Rigo0825/ECEN_404/PartOrderLlist/PartOrderList.jpg

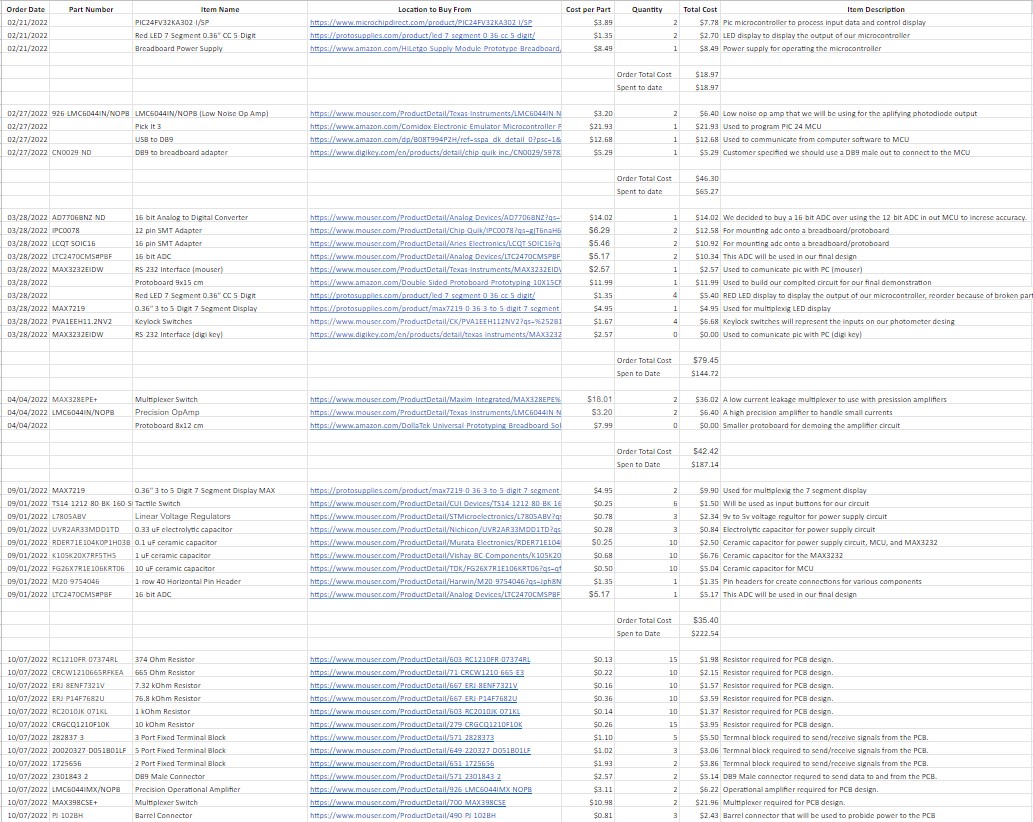
PartOrderLlist/PartOrderList.jpg
