Rigo0825/ECEN_404/README.md

# README

## Team 18 - Photometer ##

* Rigoberto Olivares
* Richard Lopez
* Hunter Cothran

## Introduction ##

This is a project for ECEN 404 - Electrical Design Lab. The project objective is to create a photometer that can be used to meassure the brightnes
of distant stars. This github repository will be used to document the code and design used in creating the photometer. Additionally, a "log" folder
will be used to give weekly written updates on the team's progress and struggles.

## Required Software ##

* MPLAB X IDE - 6.00

## Required Hardware ##

* PIC24FV32KA302
* PicKit 3 or equivalent pic microcontroller programmer
* Various other components

## External Deps  ##

* Git - Download the latest version at https://git-scm.com/book/en/v2/Getting-Started-Installing-Git
* MPLAB XC16 C-Compiler - Download the latest version at https://www.microchip.com/en-us/tools-resources/develop/mplab-xc-compilers

## Installation ##

Download this code repository by using git:

 git clone https://github.com/Rigo0825/Team18_Photometer.git

## Extra Help

Visit https://microchipdeveloper.com/projects:start for example project on programming pic mirocontrollers.
