Rigo0825/ECEN_404/Design/Microcontroller.pdf

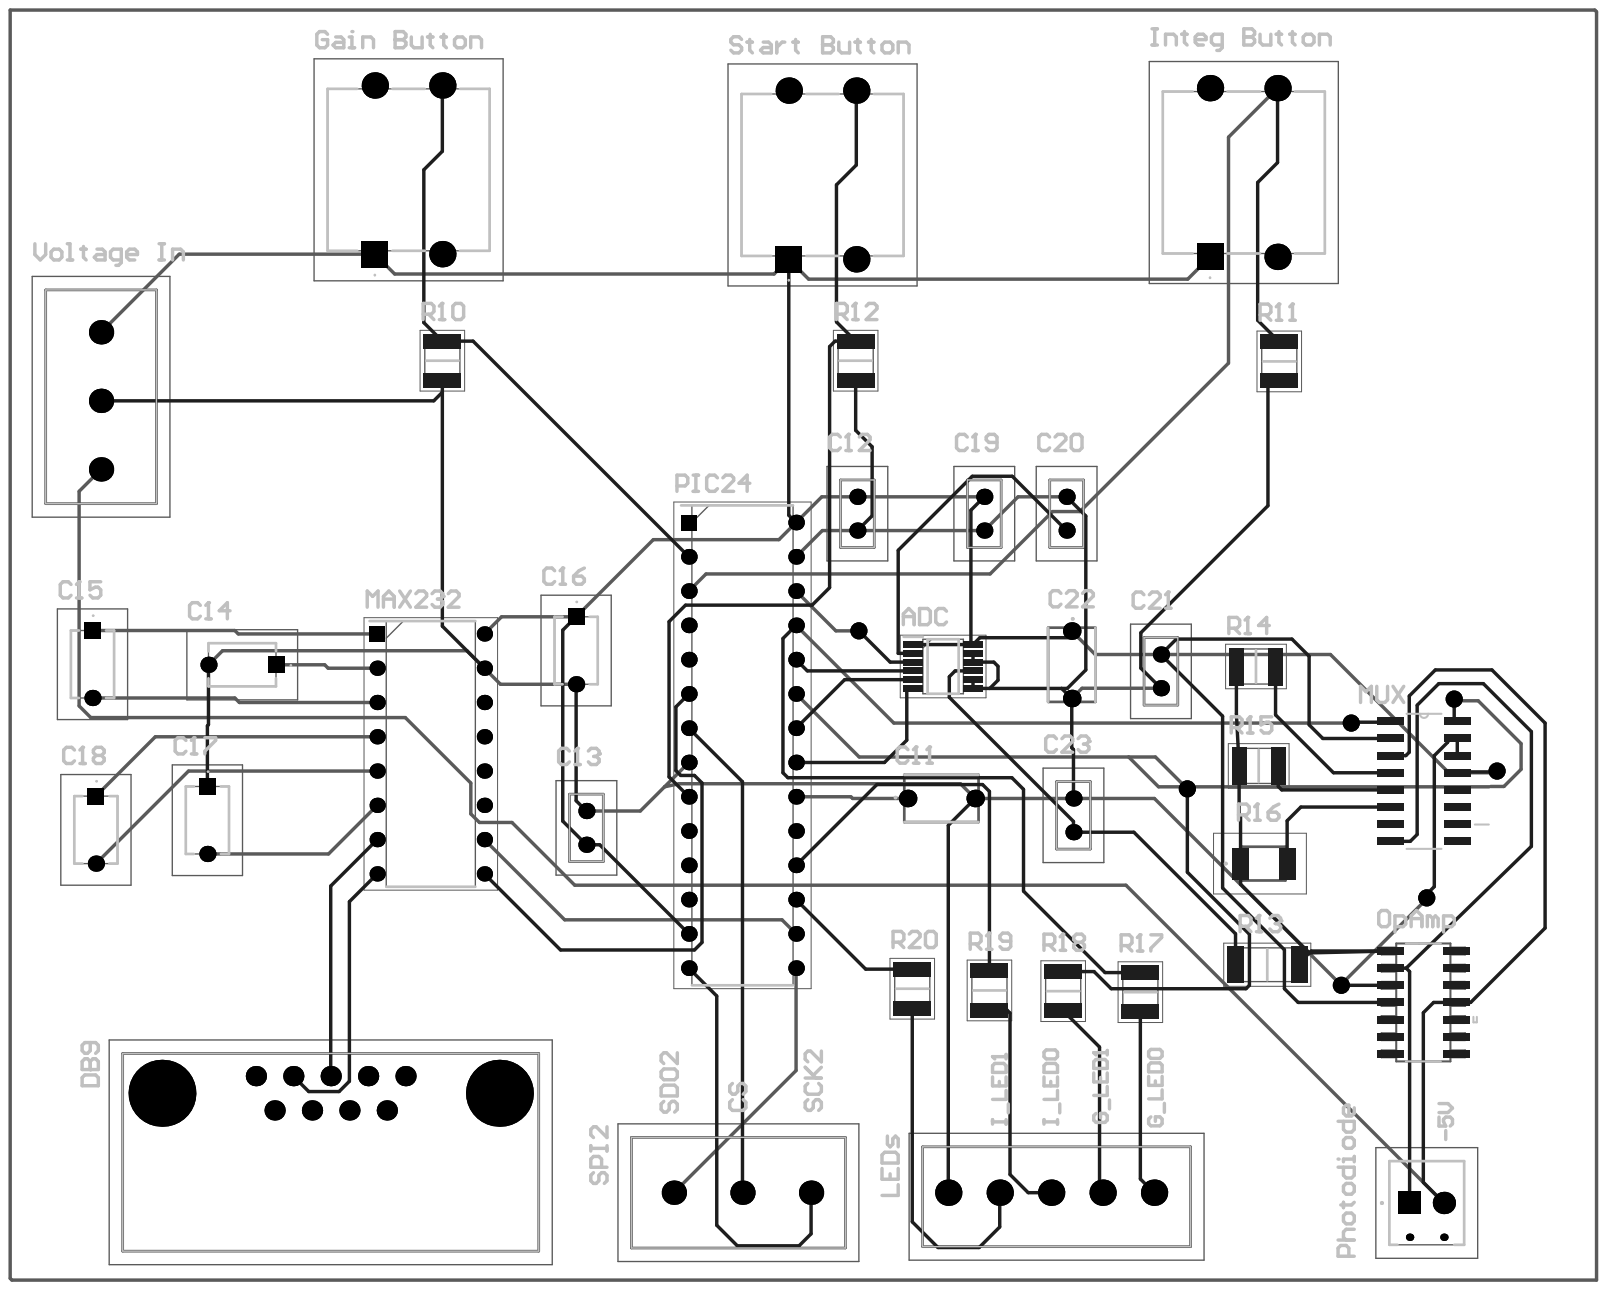
[picture p47: page 1]
