Rigo0825/ECEN_404/Design/Microcontroller_Schematic.pdf

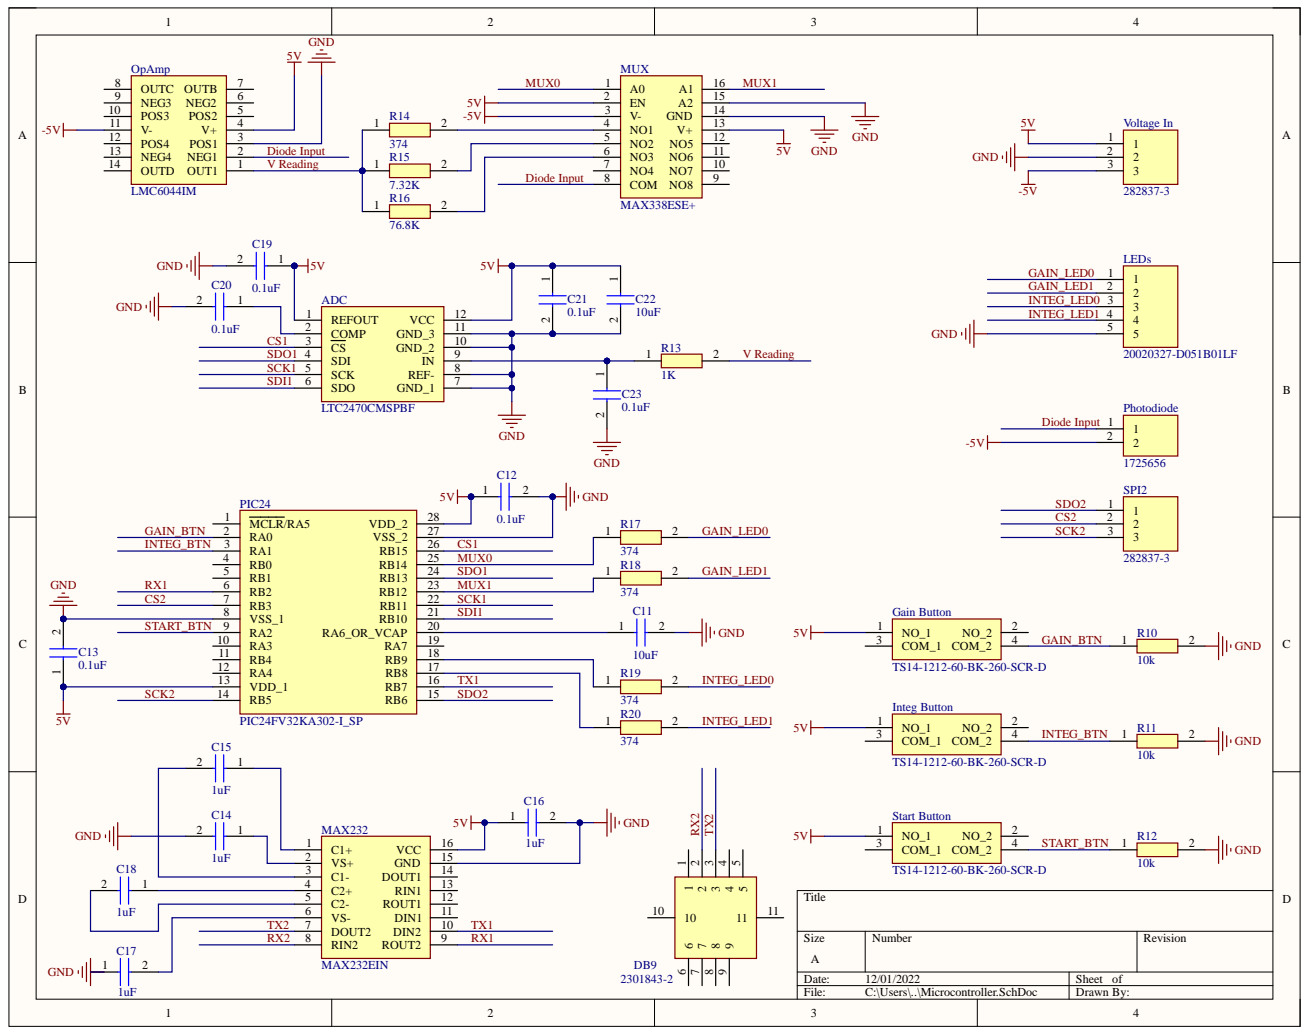
[picture p48: page 1]
