Rigo0825/ECEN_404/Design/Power_Supply.pdf

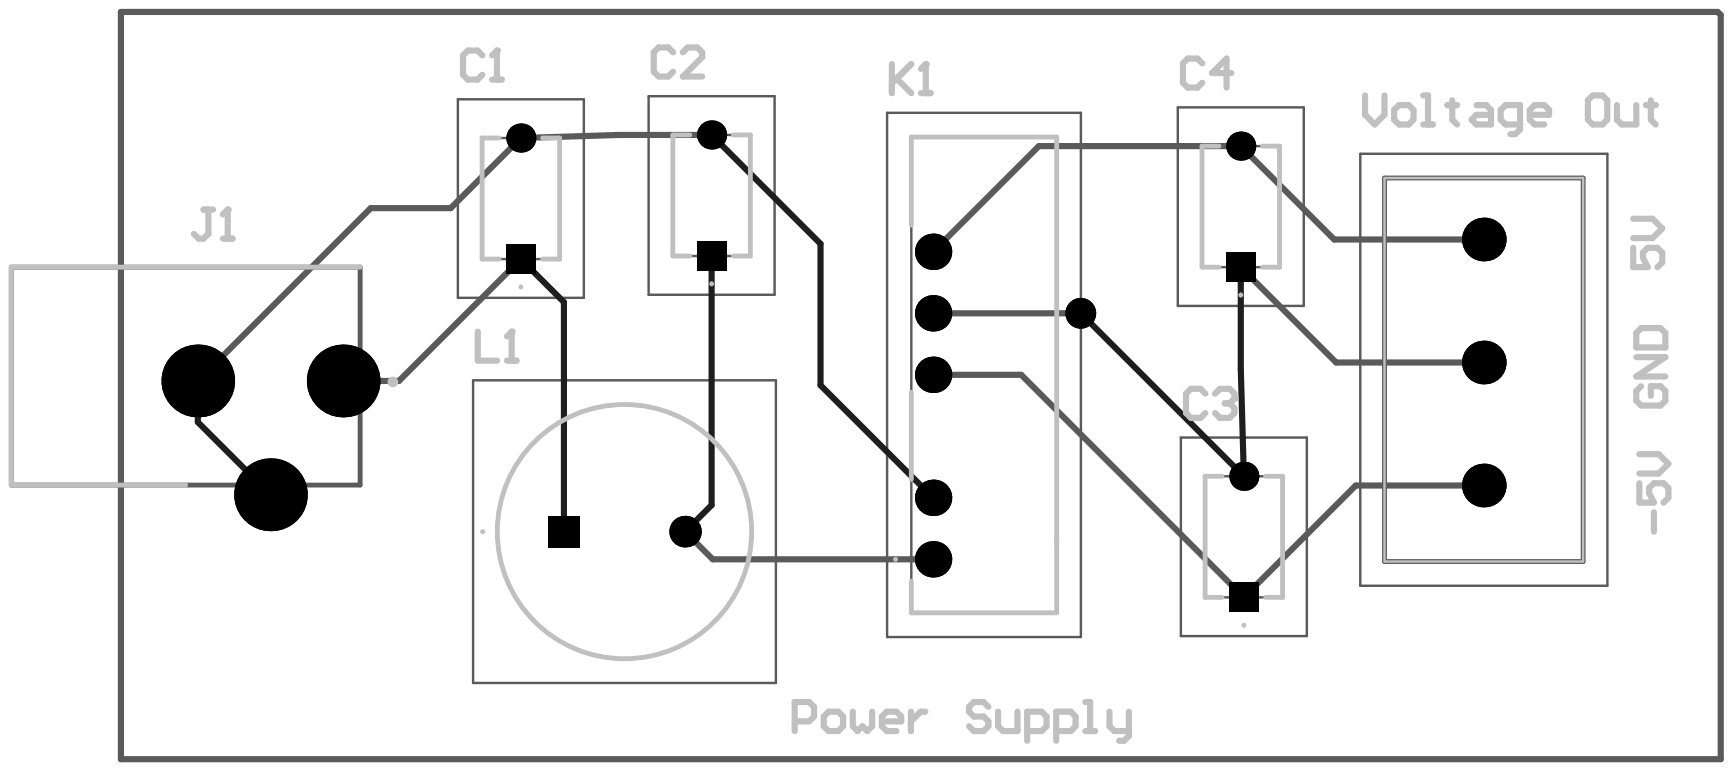
[picture p49: page 1]
