Rigo0825/ECEN_404/Design/Power_Supply_Schematic.pdf

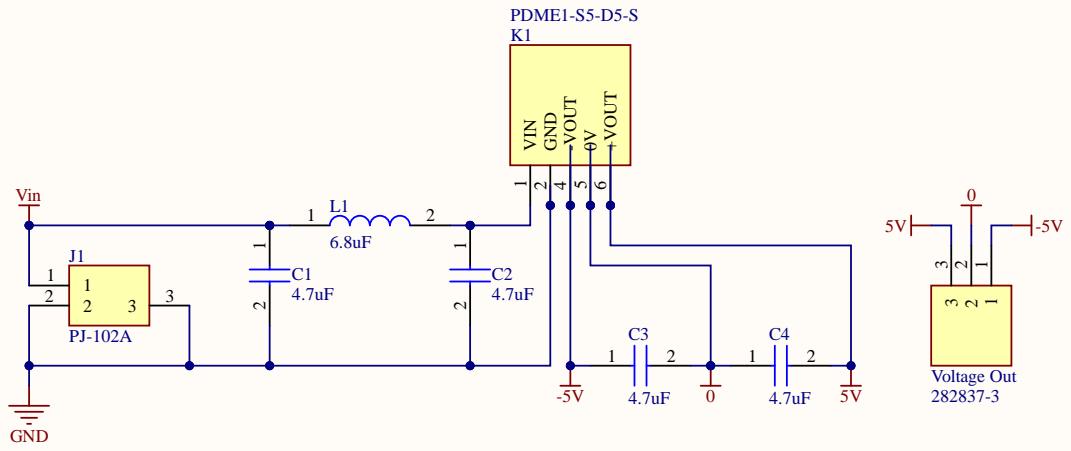
[picture p50: page 1]
